JavierIH/raider/README.md

# Raider 

NOTA: Actualmente la programación en OpenCM no compila con versiones posteriores a v1.0.1

# License

<p align="center">

</p>

# Attribution

FindZBar0.cmake: http://code.google.com/p/low-cost-vision-2012/

Original Serialib: http://serialib.free.fr

Fuzzylite: http://www.fuzzylite.com/
