JavierIH/raider/code/python/globalRobotExpo-16/notas.txt

Habilitar driver de gamepad:
$ sudo xboxdrv --silent &
