JavierIH/raider/doc/images/raider.jpg

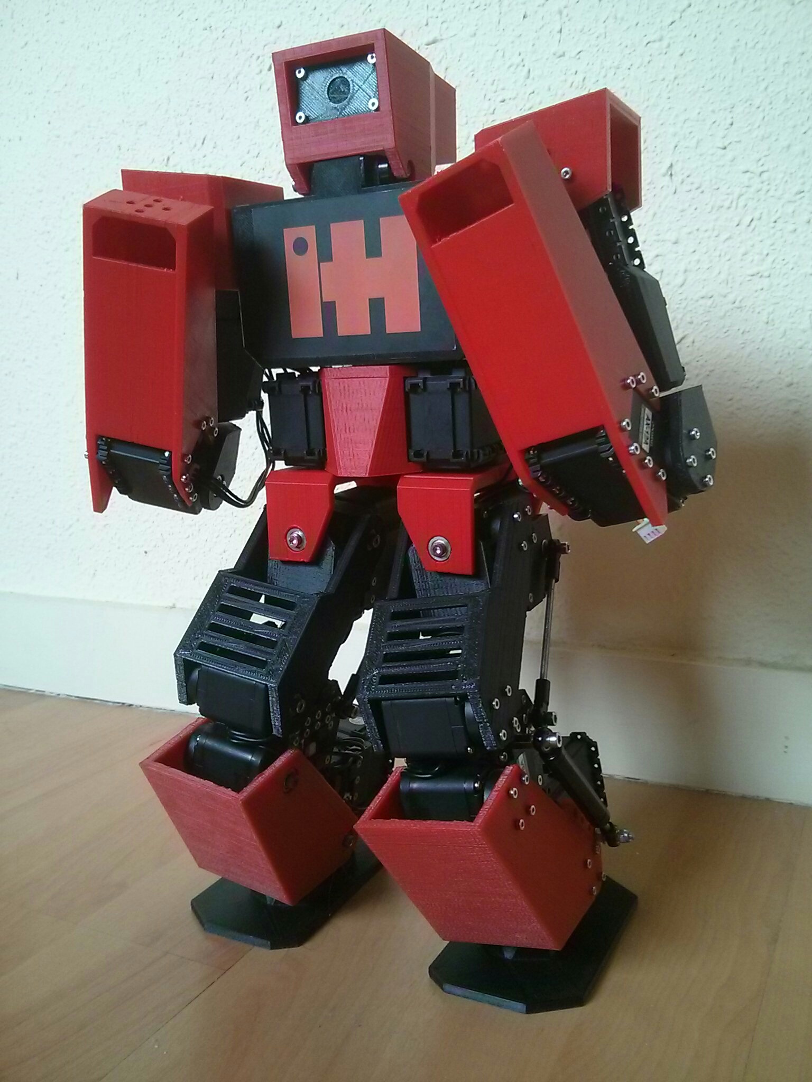
doc/images/raider.jpg
