JavierIH/raider/parts/stl/face.stl

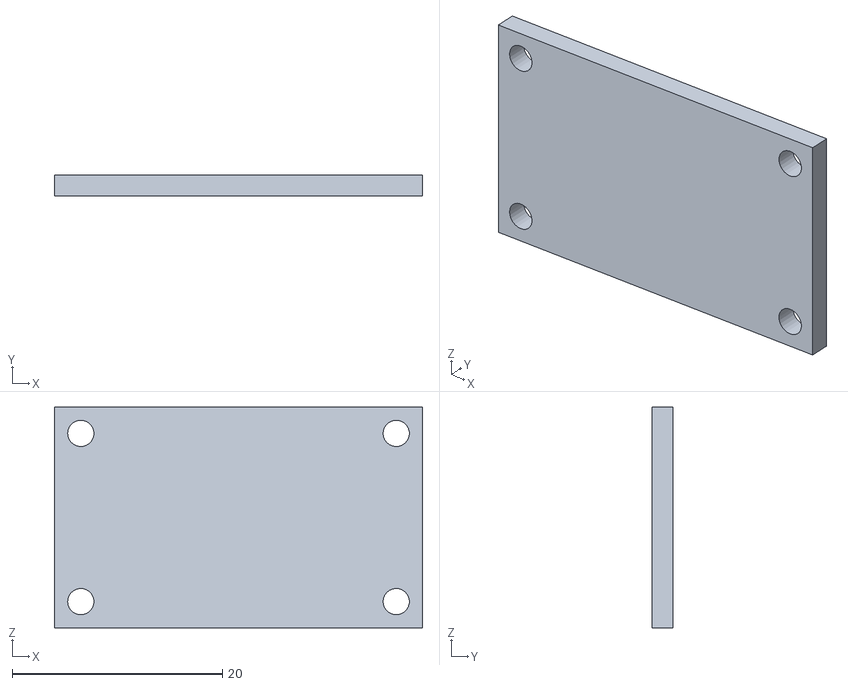
[picture p15: CAD file, 2016-01-27]
parts/stl/face.stl
35.0 x 2.00 x 21.0
