JavierIH/raider/parts/stl/face2.stl

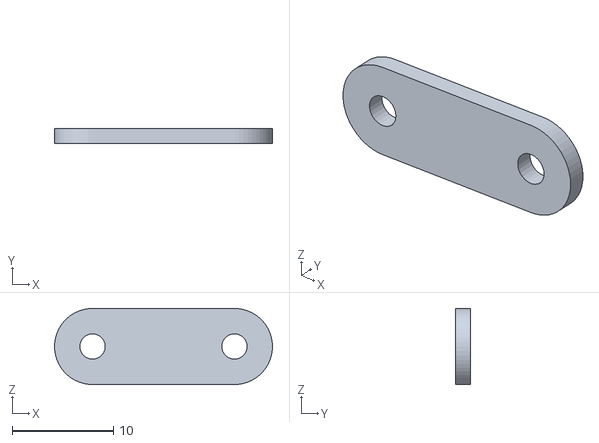
[picture p16: CAD file, 2016-01-27]
parts/stl/face2.stl
21.5 x 1.50 x 7.50
