JavierIH/raider/parts/stl/head.stl

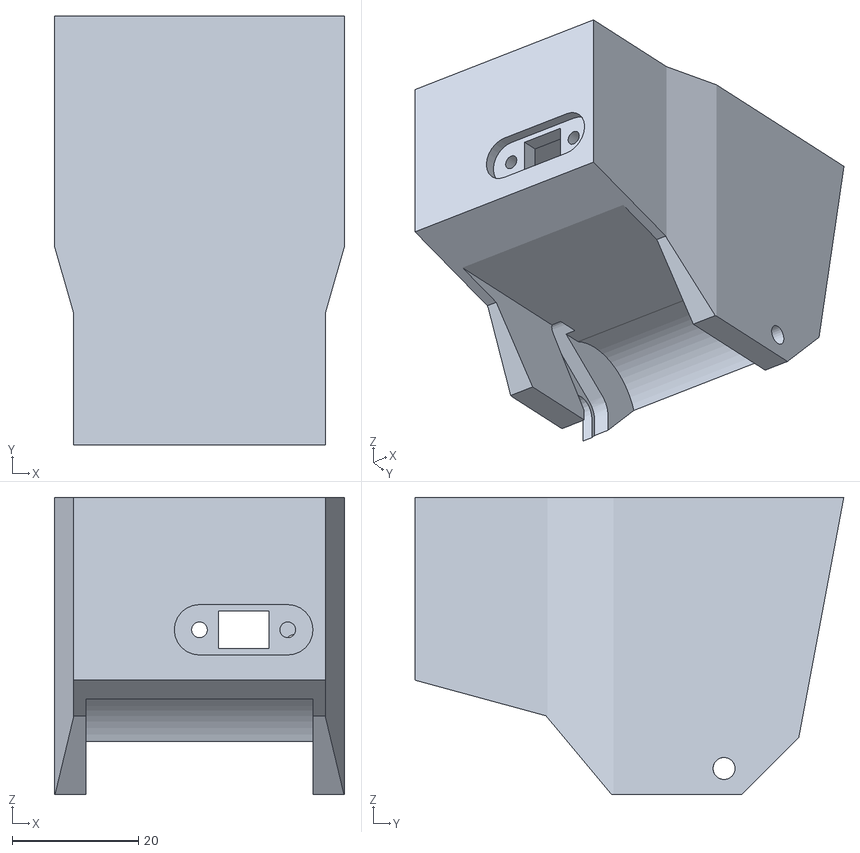
[picture p17: CAD file, 2016-01-27]
parts/stl/head.stl
46.0 x 68.0 x 47.1
