JavierIH/raider/parts/stl/hip_top.stl

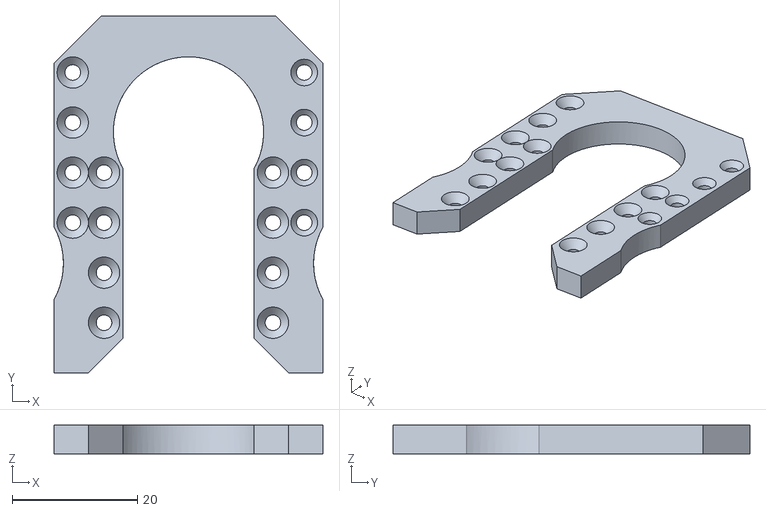
[picture p18: CAD file, 2016-01-21]
parts/stl/hip_top.stl
43.0 x 57.0 x 4.60
