JavierIH/raider/parts/stl/battery_support.stl

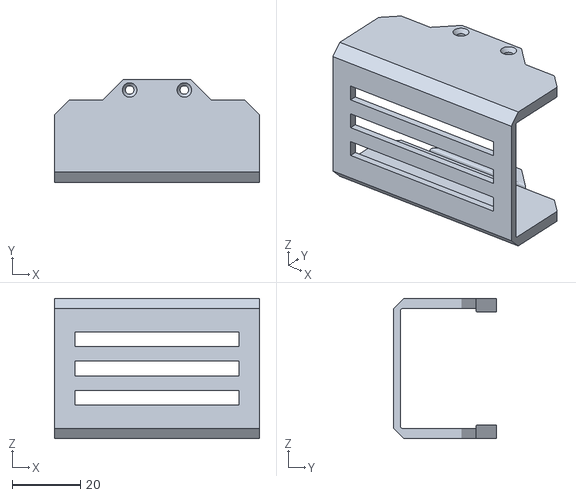
[picture p19: CAD file, 2016-01-14]
parts/stl/battery_support.stl
60.0 x 30.0 x 41.0
