JavierIH/raider/parts/stl/left_elbow.stl

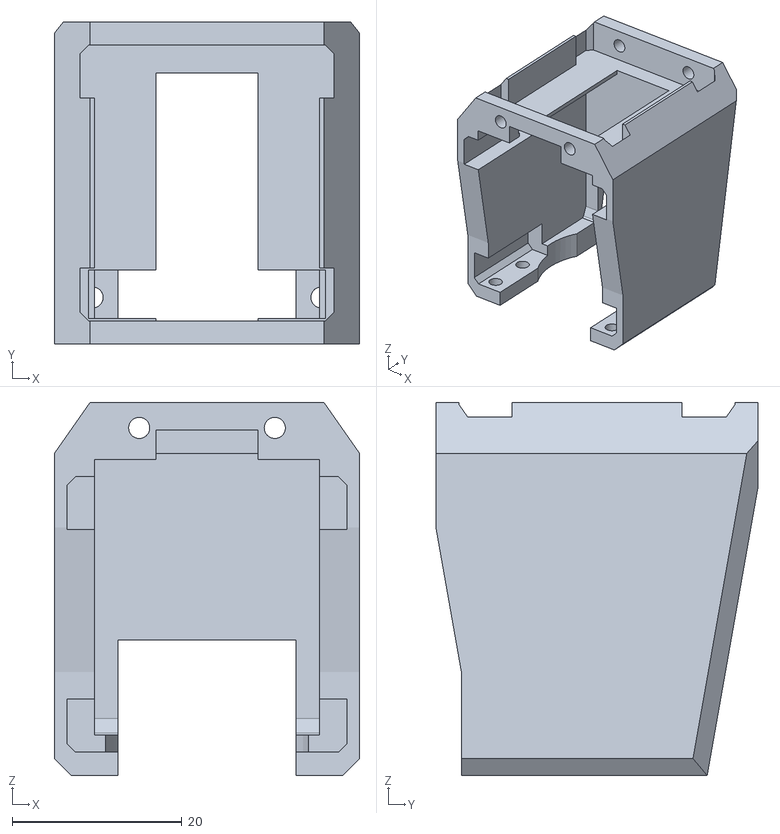
[picture p20: CAD file, 2016-01-14]
parts/stl/left_elbow.stl
36.0 x 38.0 x 44.0
