JavierIH/raider/parts/stl/left_shoulder.stl

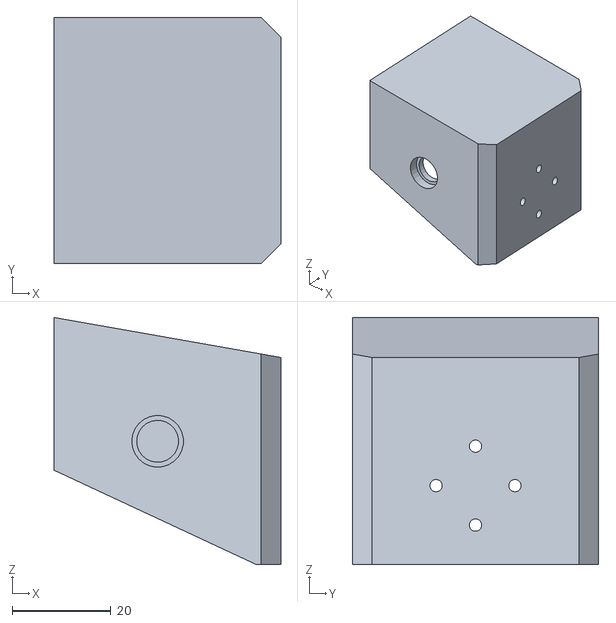
[picture p21: CAD file, 2016-01-14]
parts/stl/left_shoulder.stl
46.0 x 50.0 x 50.1
