JavierIH/raider/parts/stl/body_back.stl

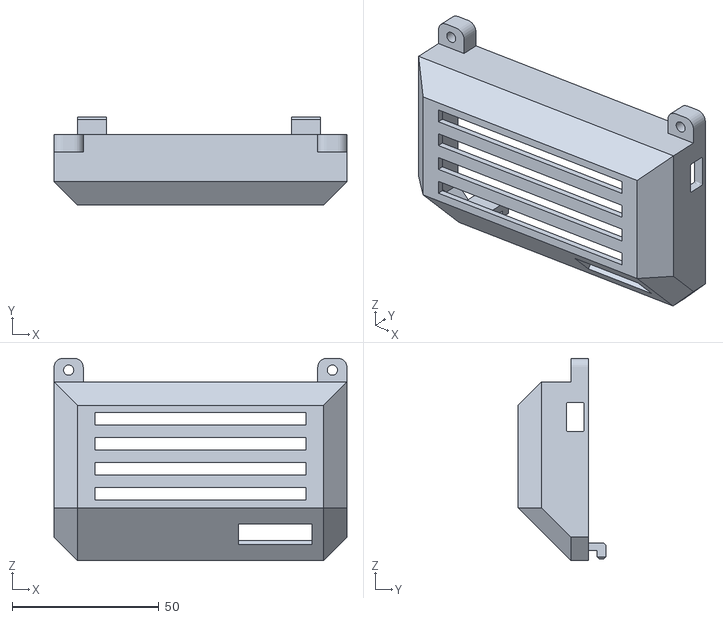
[picture p22: CAD file, 2016-01-14]
parts/stl/body_back.stl
100.0 x 30.0 x 69.0
