JavierIH/raider/parts/stl/left_arm.stl

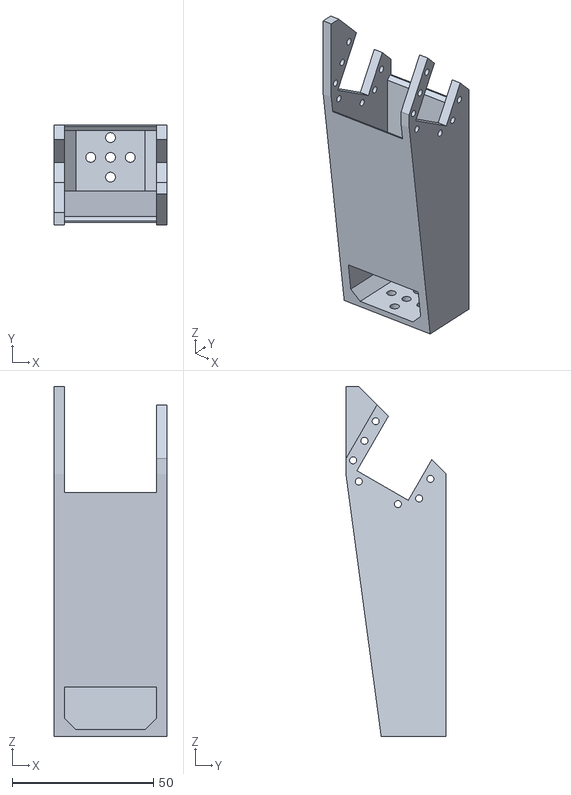
[picture p23: CAD file, 2016-01-14]
parts/stl/left_arm.stl
40.0 x 35.5 x 124.0
