JavierIH/raider/parts/stl/left_elbow_bracket.stl

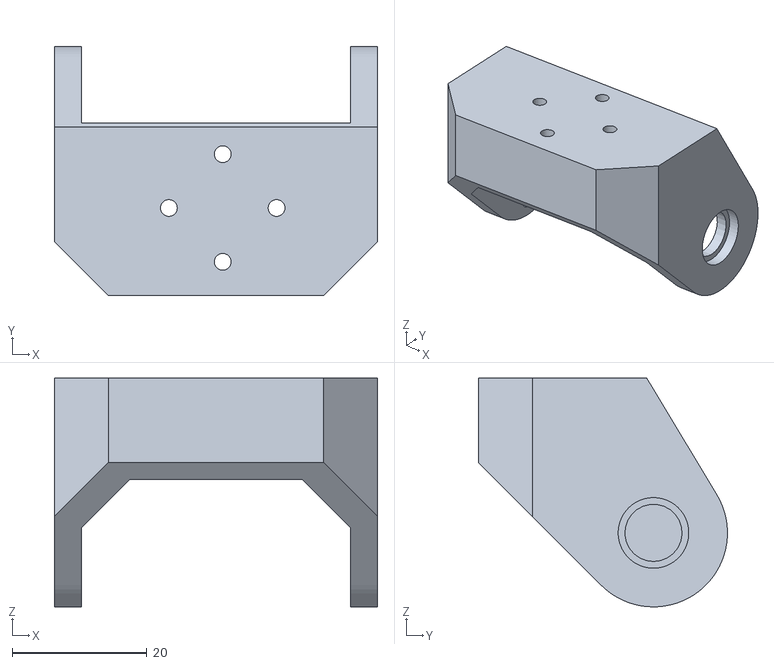
[picture p24: CAD file, 2016-01-14]
parts/stl/left_elbow_bracket.stl
48.0 x 37.0 x 34.0
