JavierIH/raider/parts/stl/body.stl

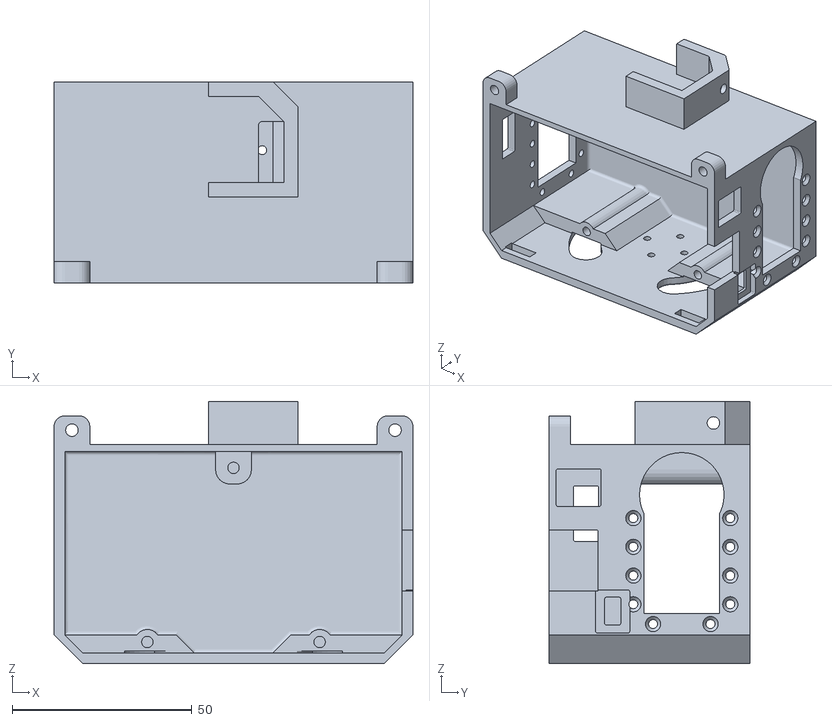
[picture p25: CAD file, 2016-01-14]
parts/stl/body.stl
100.0 x 56.0 x 73.0
