JavierIH/raider/parts/stl/lower_right_leg.stl

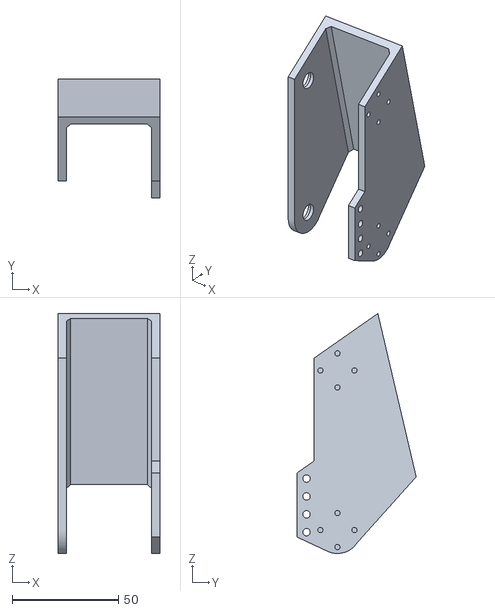
[picture p26: CAD file, 2015-08-30]
parts/stl/lower_right_leg.stl
48.0 x 56.1 x 112.7
