JavierIH/raider/parts/stl/right_ankle_A.stl

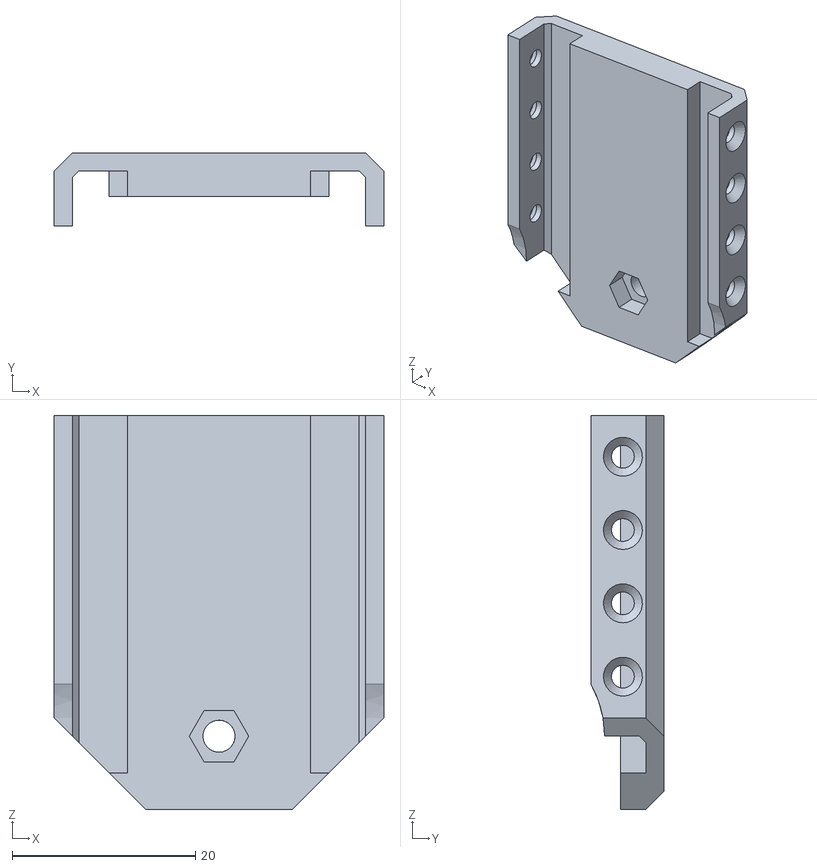
[picture p27: CAD file, 2015-08-30]
parts/stl/right_ankle_A.stl
36.0 x 8.00 x 43.0
