JavierIH/raider/parts/stl/left_foot.stl

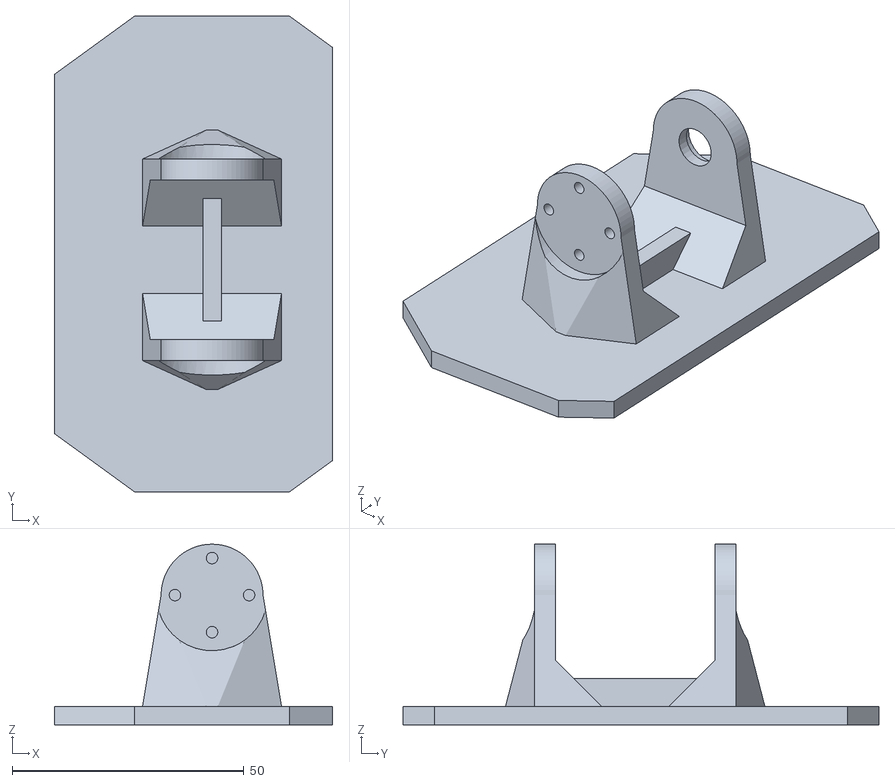
[picture p28: CAD file, 2015-08-30]
parts/stl/left_foot.stl
60.0 x 102.7 x 39.0
