JavierIH/raider/parts/stl/right_groin_B.stl

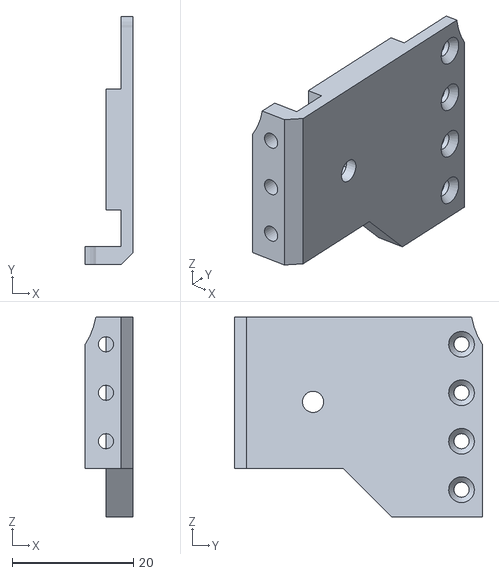
[picture p29: CAD file, 2015-08-30]
parts/stl/right_groin_B.stl
8.00 x 41.0 x 33.0
