JavierIH/raider/parts/stl/upper_left_leg.stl

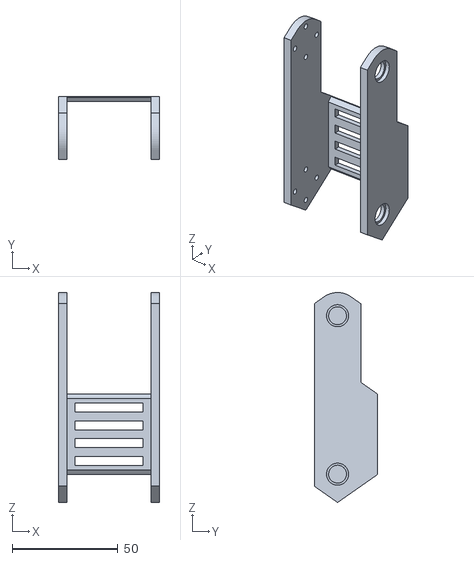
[picture p30: CAD file, 2015-08-30]
parts/stl/upper_left_leg.stl
48.0 x 30.0 x 99.4
