JavierIH/raider/parts/stl/right_ankle_B.stl

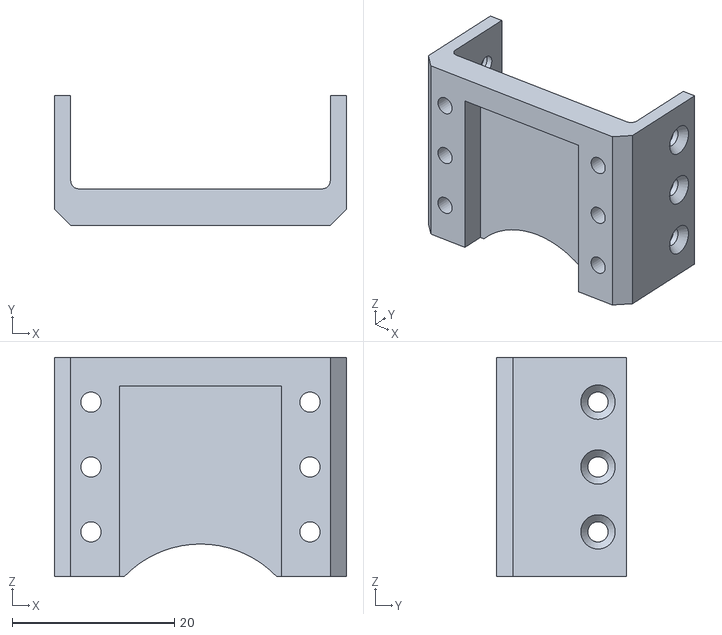
[picture p31: CAD file, 2015-08-30]
parts/stl/right_ankle_B.stl
36.0 x 16.0 x 27.0
