JavierIH/raider/parts/stl/hip_chassis.stl

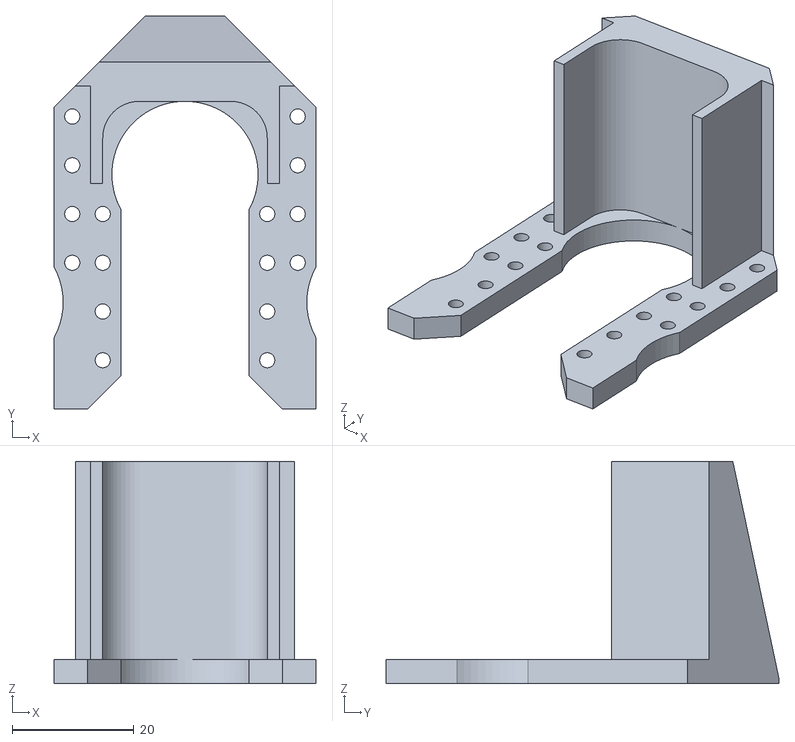
[picture p32: CAD file, 2015-08-30]
parts/stl/hip_chassis.stl
43.0 x 64.5 x 36.5
