JavierIH/raider/parts/stl/left_leg_bracket.stl

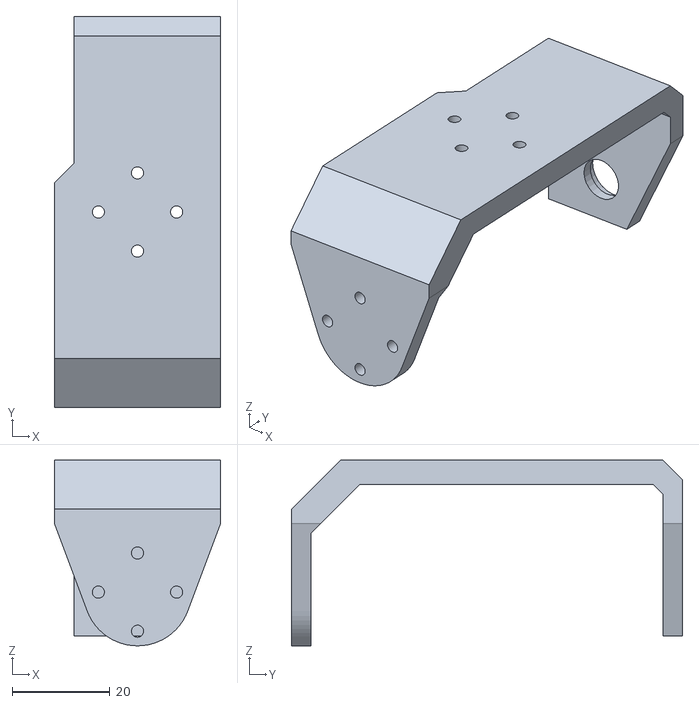
[picture p33: CAD file, 2015-08-30]
parts/stl/left_leg_bracket.stl
34.0 x 80.0 x 38.0
