JavierIH/raider/parts/stl/knee.stl

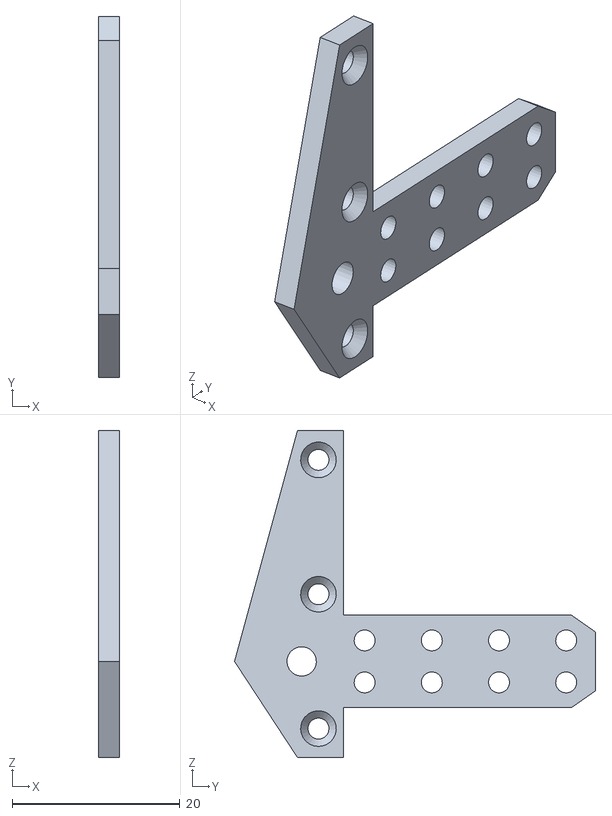
[picture p34: CAD file, 2015-08-12]
parts/stl/knee.stl
2.50 x 43.0 x 38.9
