JavierIH/raider/parts/stl/knee_damper.stl

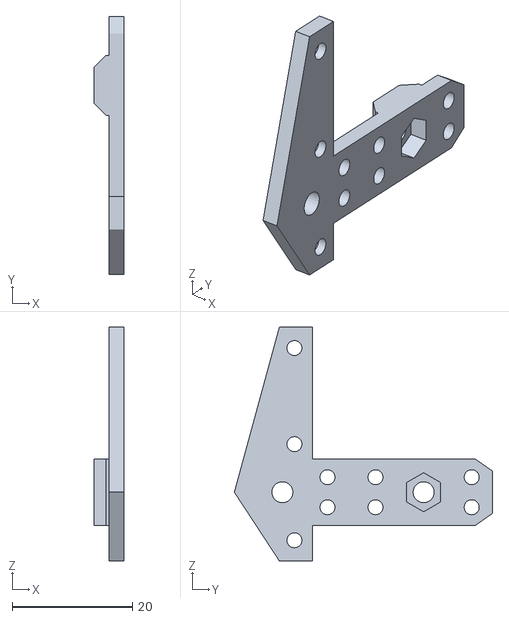
[picture p35: CAD file, 2015-08-12]
parts/stl/knee_damper.stl
5.00 x 43.0 x 38.9
