JavierIH/raider/(list of files, cad)

Other CAD files:
parts/stl/right_elbow.stl
parts/stl/right_elbow_bracket.stl
parts/stl/right_arm.stl
parts/stl/right_shoulder.stl
parts/stl/lower_left_leg.stl
parts/stl/right_groin_A.stl
parts/stl/left_groin_B.stl
parts/stl/right_foot.stl
parts/stl/upper_right_leg.stl
parts/stl/left_groin_A.stl
parts/stl/right_leg_bracket.stl
