JavierIH/raider/(threads)

Thread 1 (2015-01-30):

Buscar sistema TTS libre para que Raider hable

JavierIH, 2015-01-30:

JavierIH, 2015-01-30:
...Y quizás mas importante, conectar un altavoz al robot!

JavierIH, 2015-03-22:
eSpeak + USB sound card?

JavierIH, 2015-08-30:
Since i have decided not putting a speaker on Raider, this issue has no sense

Closed 2015-08-30.
