JavierIH/raider/(list of files, drawings)

Other design files:
electronic/shield.dsn
