JavierIH/raider/electronic/shield.sch

## KiCad design electronic/shield.sch (2014-09-09)

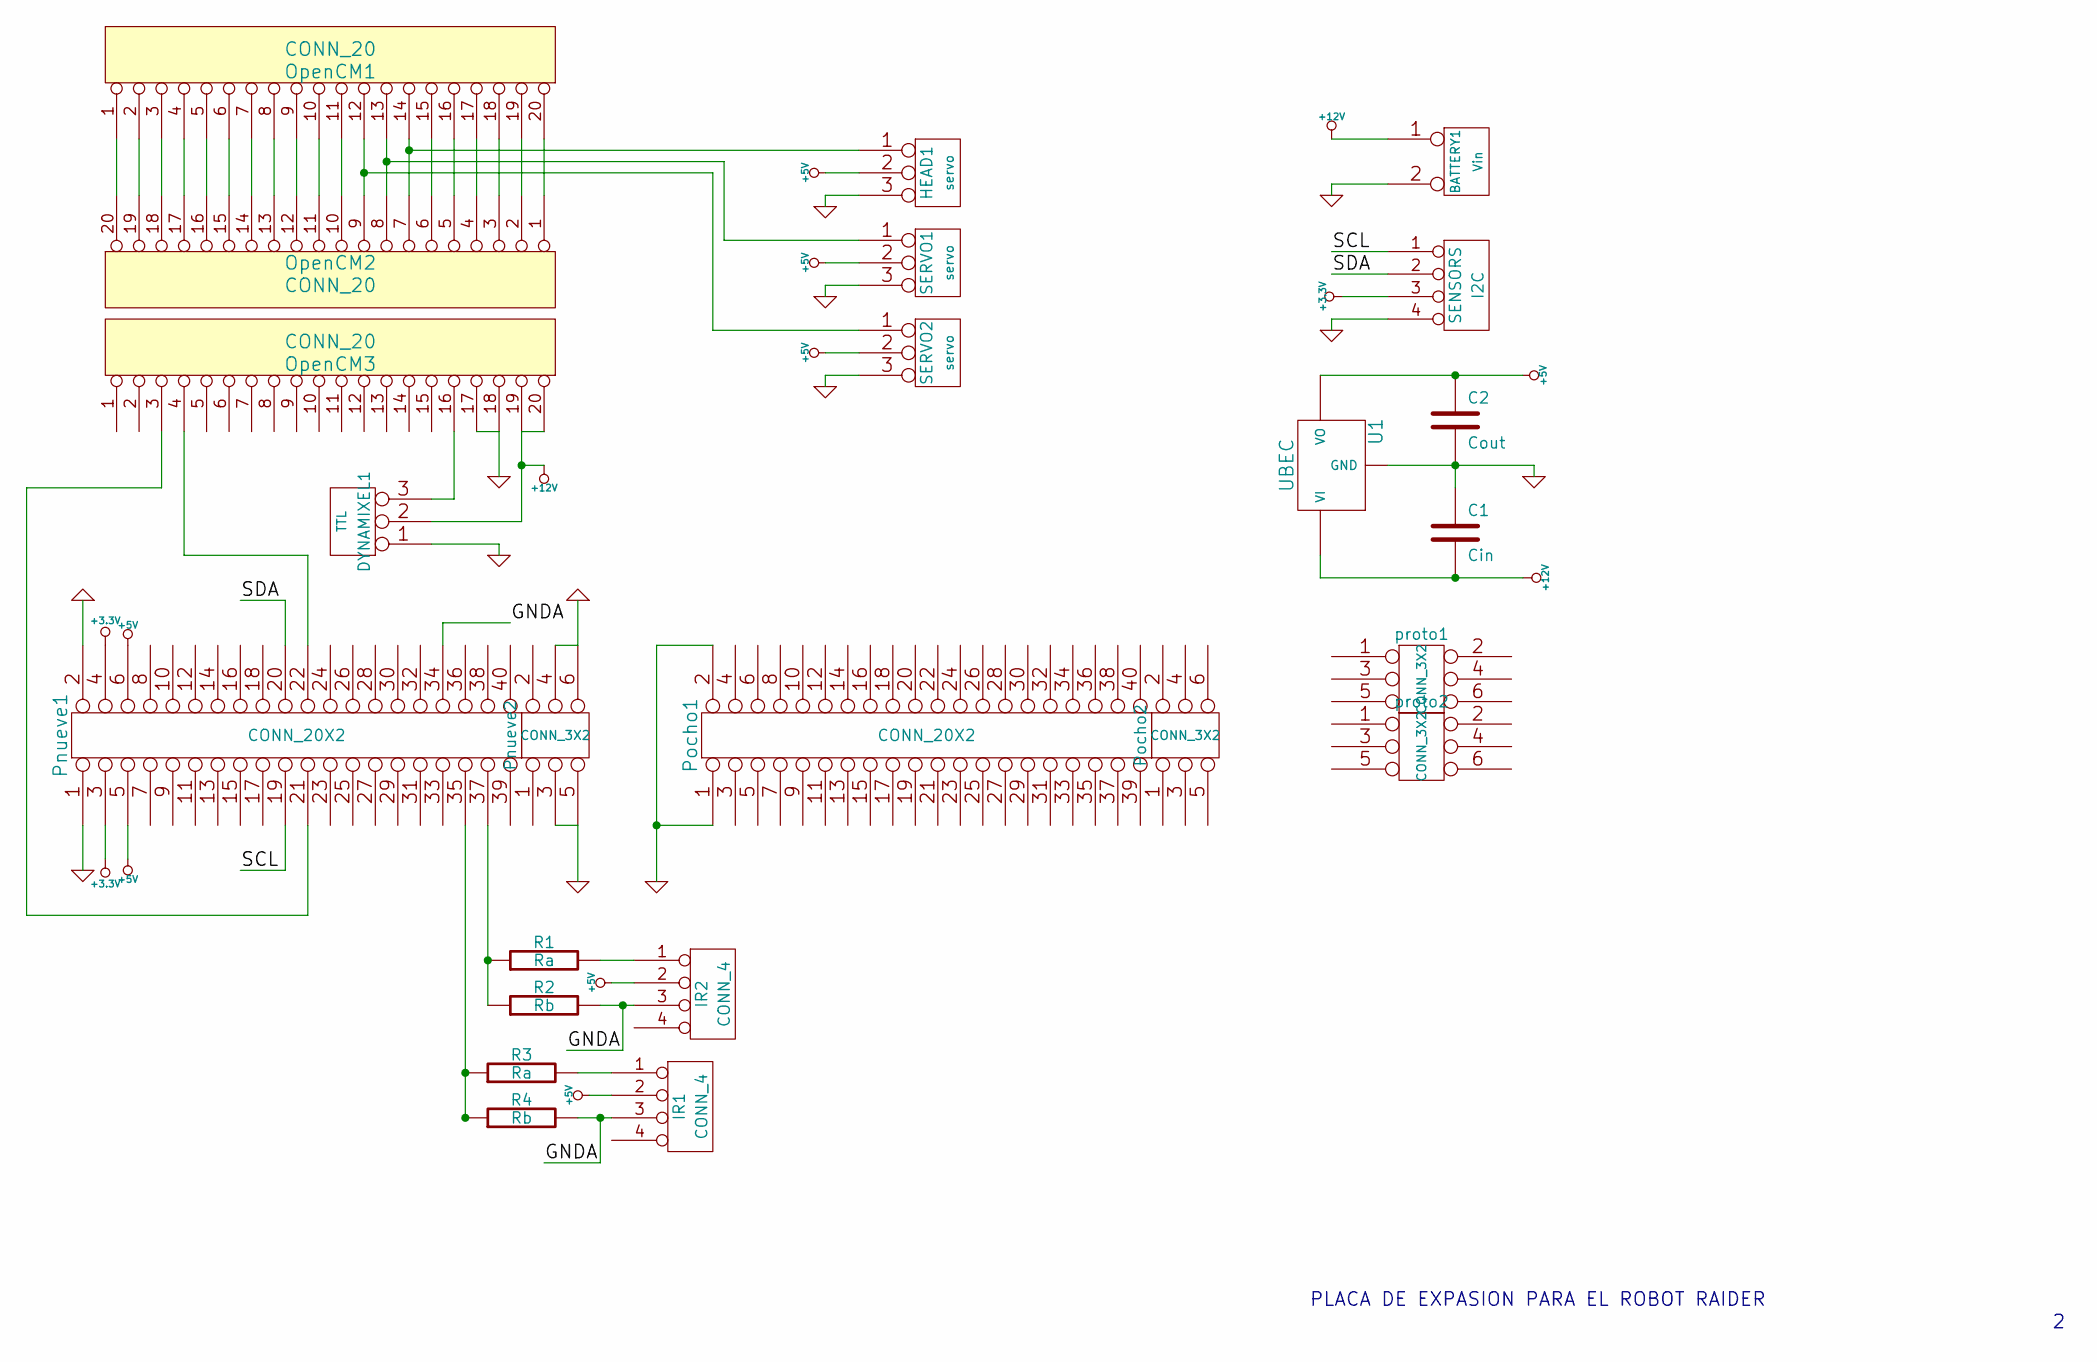
[picture p36: schematic shield.sch]

Parts:
BATTERY1: Vin
C1: Cin
C2: Cout
DYNAMIXEL1: TTL
HEAD1: servo
IR1, IR2: CONN_4
OpenCM1, OpenCM2, OpenCM3: CONN_20
Pnueve1: CONN_20X2
Pnueve2: CONN_3X2
Pocho1: CONN_20X2
Pocho2: CONN_3X2
R1, R3: Ra
R2, R4: Rb
SENSORS: I2C
SERVO1, SERVO2: servo
U1: UBEC
proto1, proto2: CONN_3X2

Connections:
+3.3V: Pnueve1.3, Pnueve1.4, SENSORS.3
+5V: C2.1, HEAD1.2 (PM), IR1.2, IR2.2, Pnueve1.5, Pnueve1.6, SERVO1.2 (PM), SERVO2.2 (PM), U1.VO
+12V: BATTERY1.1, C1.2, DYNAMIXEL1.2 (PM), OpenCM3.19, OpenCM3.20, U1.VI
GND: BATTERY1.2 (PM), C1.1, C2.2, DYNAMIXEL1.1, HEAD1.3, OpenCM3.17, OpenCM3.18, Pnueve1.1, Pnueve1.2, Pnueve2.3, Pnueve2.4, Pnueve2.5, Pnueve2.6, Pocho1.1, Pocho1.2, SENSORS.4, SERVO1.3, SERVO2.3, U1.GND
GNDA: IR1.3, IR2.3, Pnueve1.34, R2.2, R4.2
unnamed: DYNAMIXEL1.3, OpenCM3.16
unnamed: HEAD1.1, OpenCM1.14, OpenCM2.7
unnamed: IR1.1, R3.2
unnamed: IR2.1, R1.2
unnamed: OpenCM1.1, OpenCM2.20
unnamed: OpenCM1.2, OpenCM2.19
unnamed: OpenCM1.3, OpenCM2.18
unnamed: OpenCM1.4, OpenCM2.17
unnamed: OpenCM1.5, OpenCM2.16
unnamed: OpenCM1.6, OpenCM2.15
unnamed: OpenCM1.7, OpenCM2.14
unnamed: OpenCM1.8, OpenCM2.13
unnamed: OpenCM1.9, OpenCM2.12
unnamed: OpenCM1.10, OpenCM2.11
unnamed: OpenCM1.11, OpenCM2.10
unnamed: OpenCM1.12, OpenCM2.9, SERVO2.1
unnamed: OpenCM1.13, OpenCM2.8, SERVO1.1
unnamed: OpenCM1.15, OpenCM2.6
unnamed: OpenCM1.16, OpenCM2.5
unnamed: OpenCM1.17, OpenCM2.4
unnamed: OpenCM1.18, OpenCM2.3
unnamed: OpenCM1.19, OpenCM2.2
unnamed: OpenCM1.20, OpenCM2.1
unnamed: OpenCM3.3, Pnueve1.21
unnamed: OpenCM3.4, Pnueve1.22
unnamed: Pnueve1.35, R3.1, R4.1
unnamed: Pnueve1.37, R1.1, R2.1
SCL: Pnueve1.19, SENSORS.1
SDA: Pnueve1.20, SENSORS.2

Notes on the sheet:
PLACA DE EXPASION PARA EL ROBOT RAIDER
