JavierIH/raider/code/opencm/motion/motion.ino

#include <Servo.h>
#include "raider_motion.h"

//STATE SIGNALS
#define STOP_BUTTON 0
#define STATE_LED 1

//BAUD RATE FOR COMMUNICATION
#define BBB_BAUD_RATE 9600
#define BT_BAUD_RATE 9600

Robot raider;

  
void setup() {
//  Serial2.begin(BT_BAUD_RATE); //Bluetooth
    Serial3.begin(BBB_BAUD_RATE); //Beaglebone
//    SerialUSB.begin();

    pinMode(BOARD_LED_PIN, OUTPUT);
    pinMode(STOP_BUTTON, INPUT);
    pinMode(STATE_LED, OUTPUT);

    raider.init();
}

bool flag=0;

void loop() {
  digitalWrite(BOARD_LED_PIN, HIGH);
  if(digitalRead(STOP_BUTTON)){
    digitalWrite(STATE_LED, HIGH);
    raider.defense();
    flag=1;
  }
  else{
    digitalWrite(STATE_LED, LOW);
    if (flag){
      delay(5000);
      flag=0;
    }
    if(Serial3.available()){
      char command=Serial3.read();
      digitalWrite(BOARD_LED_PIN, LOW);
      raider.controller(command);
      Serial3.flush();
    }
  }/**/
}
