JavierIH/raider/code/cpp/src/test/test_voronoi.cpp

/**
 * Code for thinning a binary image using Zhang-Suen algorithm.
 */
#include <opencv2/imgproc/imgproc.hpp>
#include <opencv2/highgui/highgui.hpp>
#include "../libraries/raider/raider.h"
#include "../libraries/eye/eye.h"
#include <iostream>
#include <math.h>


using namespace cv;

Raider raider;

int main()
{
    int contador=0;
    while(1){
        char c=waitKey(50);
        if (c=='\n'||c=='a') return 0;

        Mat image=raider.getFrame();
        imshow("original", image);
        int size_factor=1;
        cv::Size size(160*size_factor,120*size_factor);
        resize(image,image,size);
        standardShow(image,"movida");
        Vec2i way_result=raider.findWay(image);
        raider.findWay(image);//,10*size_factor,20);

        if(abs(way_result[0])>10*size_factor){ // PARAMETRO DISTANCIA
            if(way_result[0]>0) report(OK,"E -> Paso lateral a la derecha");
            if(way_result[0]<0) report(OK,"Q -> Paso lateral a la izquierda");
        }
        else{
            if(abs(way_result[1])>20){ // PARAMETRO ANGULO
                if(way_result[1]<0) report(OK,"D -> Girar a la izquierda");
                if(way_result[1]>0) report(OK,"A -> Girar a la derecha");
            }
            else report(OK,"W -> Avanza recto");
        }
        contador++;
    }
}
