JavierIH/raider/(commit log)

2013-12-07 Piezas varias
    [Brazo.scad, Cabeza.scad, JuntaDeTobillo.scad, PunoBoxeo.scad, TapaCabeza.scad]
2013-12-07 Piezas nuevas
    Muuuchas piezas
    [Codo.scad, Cuello.scad, Entrepierna.scad, Gripper.scad, Hombro.scad, Pierna.scad, SoporteBateria.scad]
2013-12-07 Update README.md
    Ya basta de chorradas -_-
2013-12-08 Subete de una vez!!!!!!!!!!
2013-12-08 Morid archivos de prueba
2013-12-08 Stls por qui y por alla
    [Brazo.stl, Cabeza.stl, Codo.stl, Cuello.stl]
2013-12-10 Lector de sensores de la version 1 de Raider
    Lectura y procesamiento de datos de multiples sensores. Rula en una
    teensy, pero es facilmente portable.
2013-12-10 Piezas y mas cosas viejas
    [CabezaV1.scad, Pierna.stl, PiesV1.scad, SoporteBateriaV1.scad, TapaCabezaV1.scad]
2013-12-10 Variacion del tobillo invertido
    [JuntaDeTobillo.scad, JuntaDeTobillo.stl]
2013-12-15 Remodelacion de hombros
    Preparados para la impresión
    [Hombro.scad, Hombro.stl]
2013-12-20 Cabeza V2
    Cabeza con camara
    [Brazo.scad, Brazo.stl, Cabeza.stl, CabezaV1.scad, Codo.scad, Codo.stl, Cuello.scad, Cuello.stl]
2013-12-20 A mas toco mas la lio
    Menos mal que esto solo lo leo yo
    [Brazo.scad, Brazo.stl, Cabeza.stl, CabezaV1.scad, CabezaV2.scad, Codo.scad, Codo.stl, Cuello.scad]
2013-12-21 Buenas noches
    Y ahora a dormir!
    [Codo.scad, Codo.stl, Entrepierna.stl]
2014-01-09 Cuello2: con buenas medidas / sin anclajes
    Bancada del servomotor del cuello. Las medidas son buenas pero aún falta
    diseñar el anclaje al cuerpo. En esta pieza ya debería poder montarse la
    cabeza.
    [Cuello2.scad, Cuello2.stl, PlacaCamara.scad]
2014-01-09 CabezaV2: Idea nueva!!!!
    Si va bien, esto molara mucho
    [CabezaV2+CuelloV2.scad, CabezaV2.scad, CabezaV2.stl]
2014-01-09 Giro de cruz de servo de cabeza de...
    Le da un poco mas de molaridad (mola mas)
    [CabezaV2.scad, CabezaV2.stl]
2014-01-09 Plaquita para la camara
    Danger, low cafeine level.
    [PlacaCamara.scad]
2014-01-09 raid3r library
    Sin tele y sin cerveza Javi pierde la cabeza
    [Bicep.scad, Pecho.scad, PlacaCamara.scad, PlacaCamara.stl, raid3r.scad]
2014-02-02 Espalda, cuello y CM2012
    Varias piezas y una copia de seguridad dle programa (en cm900) que
    utilicé la temporada pasada.
    [Cuello2.scad, Cuello2.stl, Espalda.scad, Espalda.stl, PlacaCamara.scad, PlacaCamara.stl]
2014-02-05 Soportes de la electornica
    [BeagleCM.scad, BeagleCM.stl, Espalda.scad, Espalda.stl]
2014-02-17 Prueba de identidad
2014-02-17 Prueba de idnentidad 2
2014-03-17 Raider el bailon
2014-03-20 movimientos simples
    chorradas varias fruto de aburrimiento efaksjdvgkajwef soy programador
    ASfdasdfasdf
2014-04-07 PiesV2 simples y fuertes
    [PiesV2.scad, PiesV2.stl]
2014-04-07 Pies (ya impresos)
    tururu
    [PiesV2b.stl]
2014-04-12 Datasheet IR
    [PiesV2.stl]
2014-04-14 Archivos dtbo para serial
2014-04-14 Joder con la estupida fecha
2014-04-15 Prueba de bones
2014-04-15 fritzing schematic
    [esquema.fzz, esquemabueno.fzz]
2014-04-16 cosas varias y me cago en la puta fecha otra vez
    [2.fzz]
2014-04-17 PATAS aux
    [SeparadorPierna.scad, SeparadorPierna.stl]
2014-04-17 Que asco de noche, asco de semana y asco de vida
    [Antebrazo.scad, SoporteBateria.scad, SoporteBateria.stl]
2014-04-19 Antebrazo molón
    literalmente
    [Antebrazo.scad, Antebrazo.stl]
2014-05-04 Esquema fritzing
    [esquemabueno.fzz]
2014-05-10 Cuello (?)
    Revisar si es la versión mas avanzada
    [Cuello2.scad, Cuello2.stl]
2014-05-12 shield en fritzing
    [esquemabueno.fzz, shield.fzz]
2014-05-12 mod shield
    [shield.fzz]
2014-05-12 Shield con kicad
    [shield.sch]
2014-05-12 OOOOHHH LOOONG PIANO
    [$shield.sch, shield.brd, shield.sch]
2014-05-12 Wow, so wired, much electric, such tolerance...
    [shield.brd]
2014-05-12 Maws placa
    [shield.brd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]
2014-05-13 Cosas nazis
    [shield.fzz]
2014-05-15 Shield por aqui
    [$shield.sch, shield.brd, shield.dsn, shield.sch]
2014-05-16 Me encanta mi nueva cmara
    [shield.brd, shield.dsn]
2014-05-16 Test de integración
2014-05-16 Pruebas de cierres y restas
2014-05-18 A saber que estoy subiendo
2014-05-19 Shield derecha
    [shield.brd, shield.dsn]
2014-05-20 Placa casi terminadASDFASF
    [shield.brd]
2014-05-20 Resta de canales
2014-05-20 Preparado para testar beaglebone
2014-05-22 Placa casi lista REVISAR
    [shield.brd]
2014-06-04 Un poco de aqui y de allá
    [CabezaV3.scad, CuelloV2.scad, CuelloV2.stl, shield.brd]
2014-06-06 Piezas para la nueva camara
    [ChasisLifecam.scad, ChasisLifecam.stl]
2014-06-06 ajuste de tolerancias
    [ChasisLifecam.scad, ChasisLifecam.stl]
2014-06-13 Piezas mejoradas
    espalda y tapa de cabeza
    [Espalda.scad, Espalda.stl, TapaCabezaV3.scad, TapaCabezaV3.stl, raid3r.scad]
2014-06-19 Mas madera para la memoria
2014-06-19 Mas madera para la memoriaa
2014-06-19 Mas madera para la memoriaaa
2014-06-26 Con sueño la lio, logico
2014-07-01 aproximación a encontrar la linea mas larga
2014-07-05 Arreglado error muy gordo
    arreglado, aleluya
    [motion.ino, raider_motion.cpp]
2014-07-06 piezas de espalda
    f
    [BoardChassis.scad, Protector.scad]
2014-07-10 Empiezo con el estupido girsoco
2014-07-10 mas cambios en I2C
2014-07-12 Mensajes de colores (debug)
2014-07-12 pruebas con debugs de colores en imu
2014-07-12 olvidandome archivos para variar
2014-07-12 Ya esta casi funcionando el imu
2014-07-12 tarde de los commits largos
2014-07-15 ok raider, ok
    [Protector.scad, Protector.stl]
2014-07-16 Pruebas de itnegración
2014-07-16 Pruebas de analogicos
2014-07-23 gripper acortado
    [Gripper.scad, Gripper.stl]
2014-08-03 prueba con imu
2014-08-03 calibración del imu
2014-08-03 tratando de configurar la brujula
2014-08-03 cambio de valores compass
2014-08-05 Refactorizado para PC
2014-08-07 placa protectora
    [Protector.scad, Protector.stl]
2014-08-07 Boton de emergencia
2014-08-08 deteccion de lineas cruda
2014-08-08 Preparando algoritmo de navegación
2014-08-09 Opencm preparado (a priori)
    [Protector.scad, Protector.stl]
2014-08-09 ajuste de parametros
2014-08-11 bug gordo en findline
    [test_opencv.cpp]
2014-08-12 movidas de al memoria
2014-08-15 memo y renombrado de piezas
    [Antebrazo.stl, BatterySupport.stl, BeagleCM.stl, BoardChassis.stl, Brazo.stl, Cabeza.stl, CabezaV2.stl, CabezaV3.scad]
2014-08-19 reestructuracion gorda de la memoria
2014-08-21 Codo nuevo
    [Codo.scad, codo.stl, codoA.stl, codoB.stl]
2014-08-23 upgrade en codos y cintura
    [Codo.scad, Entrepierna.scad, cintura2.stl, codoA.stl, codoB.stl]
2014-08-25 va la buena
2014-08-25 va la buenadsfvsdfvb
2014-08-25 inversion de bytes
2014-08-27 testing imu
2014-08-27 implementado control de caidas
2014-08-27 caidas yreajuste de sumo
2014-08-29 lio gordo de cmake
2014-09-01 prueba de vision
2014-09-01 pruebas de vision
2014-09-01 pruebas de vis
2014-09-01 pruebas de visdfhs
2014-09-02 ajuste de brujula
2014-09-02 creo que está todo
2014-09-03 ajustes en la competi
2014-09-04 commit de emergencia
2014-09-05 ajustes de sumo
2014-09-10 pieas en step
    [CuelloV2.scad, Pierna.scad, antebrazo.step, cabeza.step, chasislifecam.step, cintura.step, cintura2.step, codoL.step]
2014-09-16 Movidas de la memoria
2014-09-22 terminando la memoria
2014-09-23 Se acerca el final
2014-12-27 Cosas de gpios y algo de fuzzy
2015-01-30 RAIDER, ahora con mas fuzzy
    [2.fzz, esquema.fzz, esquemabueno.fzz, shield.fzz]
2015-03-04 Added new steps and stls
    [BatterySupport.stl, BeagleCM.stl, BoardChassis.stl, Brazo.stl, Cabeza.stl, CabezaV2.stl, Casquillos.stl, Cuello.stl]
2015-03-07 Making some fillets on legs bigger parts
    [pierna1.step, pierna1.stl, pierna2.step, pierna2.stl]
2015-03-09 Solved bad dimension on tobillo2
    [tobillo2.step, tobillo2.stl]
2015-03-09 Making a bigger room for bearings on pierna1 and pierna2
    [pierna1.step, pierna1.stl, pierna2.step, pierna2.stl]
2015-03-09 Fixing bracketPierna
    [bracketPierna.step, bracketPierna.stl, bracketPiernaD.step, bracketPiernaD.stl]
2015-03-19 Narrowed internal parts of the leg for a easier assembly
2015-03-23 Generated new stl ready to test
    [ingle1.stl, ingle2.stl, tobillo1.stl, tobillo2.stl]
2015-03-29 New parts, new body project
    [Odroid_body.fcstd]
2015-04-05 stl files for feet
    [pieL.stl, pieR.stl]
2015-04-07 Updated bracketPierna and tobillo1 parts
    [bracketPierna.step, bracketPierna.stl, tobillo2.step, tobillo2.stl]
2015-04-16 Modified bracketPierna and ingle2
    [bracketPierna.step, bracketPierna.stl, ingle2.step, ingle2.stl]
2015-06-26 Added new shorter legs
2015-07-05 Developing a better body and leg junction
2015-08-01 Modded upper leg
2015-08-02 Added stl files and updated assembly model
    [bracket_pierna_derecha.stl, ingle_derecha.stl, pierna_abajo_derecha.stl, pierna_abajo_izquierda.stl, pierna_arriba_derecha.stl, pierna_arriba_izquierda.stl, rodilla.stl, rodilla_amortiguador.stl]
2015-08-12 updated knee stls
    [rodilla.stl, rodilla_amortiguador.stl]
2015-08-14 updated stl files
    [ingle_derecha.stl]
2015-08-30 Updated hip, battery support and knees in freecad project
2015-08-30 Reorganization of 3D files
    [Antebrazo.scad, BatterySupport.scad, BatterySupport.stl, BeagleCM.scad, BoardChassis.scad, BoardChassis.stl, Brazo.scad, Brazo.stl]
2016-01-09 New prototype arms on freecad project
2016-01-10 proof of concept ready to be printed
2016-01-14 New stl parts
    [body.stl, body_back.stl, head.stl, left_arm.stl, left_elbow.stl, left_elbow_bracket.stl, left_shoulder.stl, right_arm.stl]
2016-01-14 modded elbows
    [left_elbow.stl, right_elbow.stl]
2016-01-14 Bigger battery support
    [battery_support.stl]
2016-01-16 hard refactor
    [Antebrazo.scad, BatterySupport.scad, BatterySupport.stl, BeagleCM.scad, BoardChassis.scad, BoardChassis.stl, Brazo.scad, Brazo.stl]
2016-01-16 renamed directory shield to electronic
    [shield.brd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]
2016-01-21 updated hip_top stl
    [hip_top.stl]
2016-01-27 head parts
    [face.stl, face2.stl, head.stl]
