JavierIH/raider/(notices)

Notices in the files:
doc/memoria/TFG/TFG.pdf:
Esta obra est´a licenciada bajo la licencia Creative Commons Atribuci´on-NoComercial-SinDerivadas 3.0 Unported (CC BY-NC-ND 3.0).
